evolutek/carte-vitrine-2022/V1/Output/Schematics.pdf

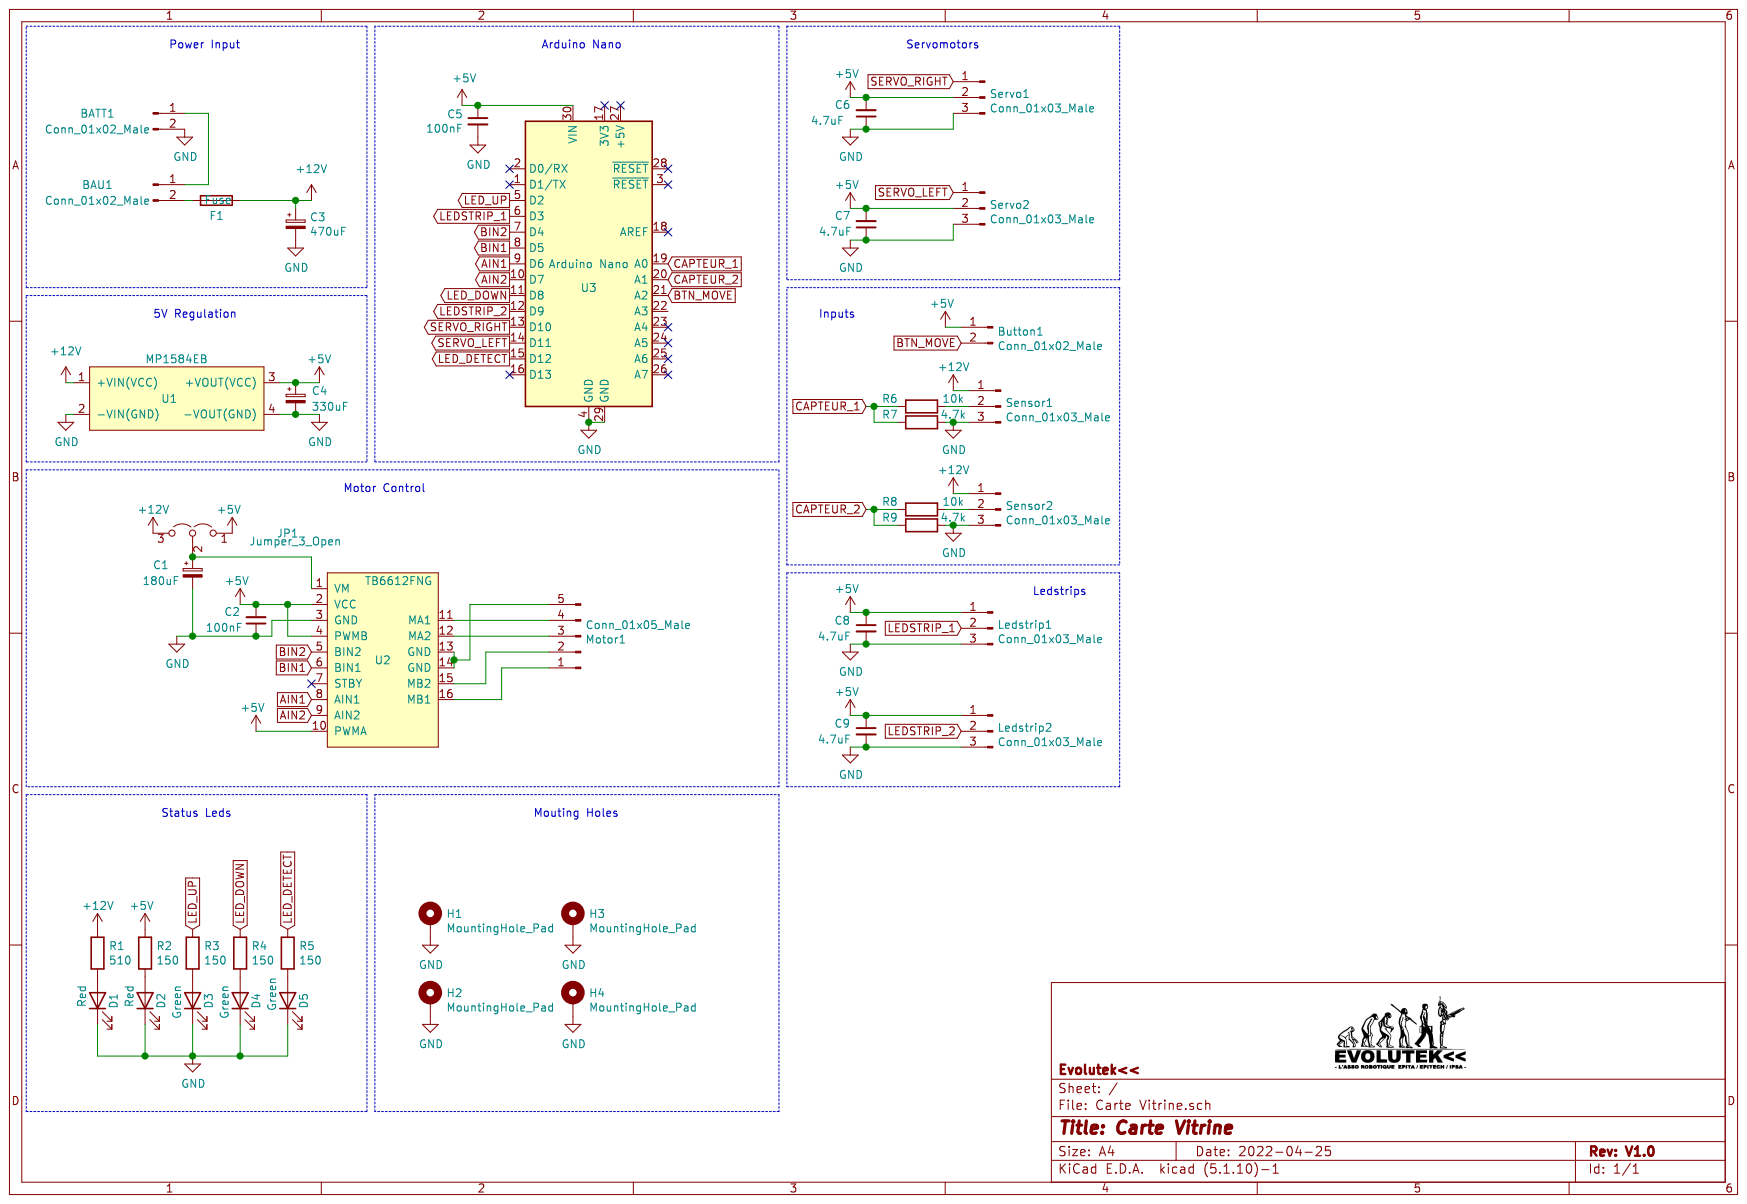
[picture p1: page 1]
