evolutek/carte-vitrine-2022/V1/Output/Front-Board.pdf

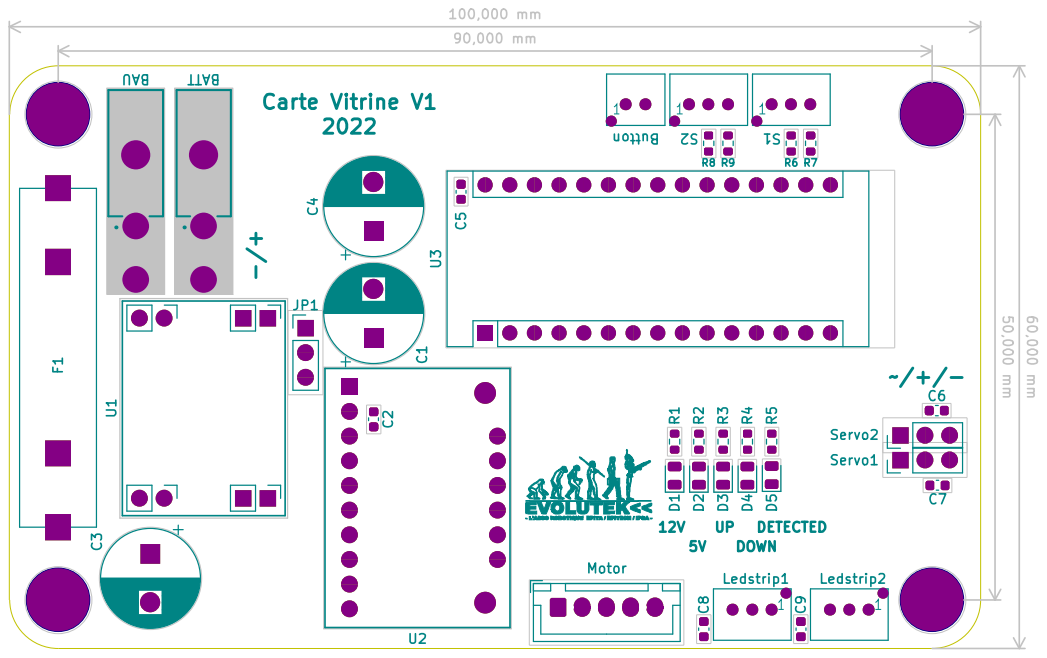
[picture p2: page 1]
