evolutek/carte-vitrine-2022/V1/Carte Vitrine.kicad_pcb

## KiCad design V1/Carte Vitrine.kicad_pcb (2022-04-25)

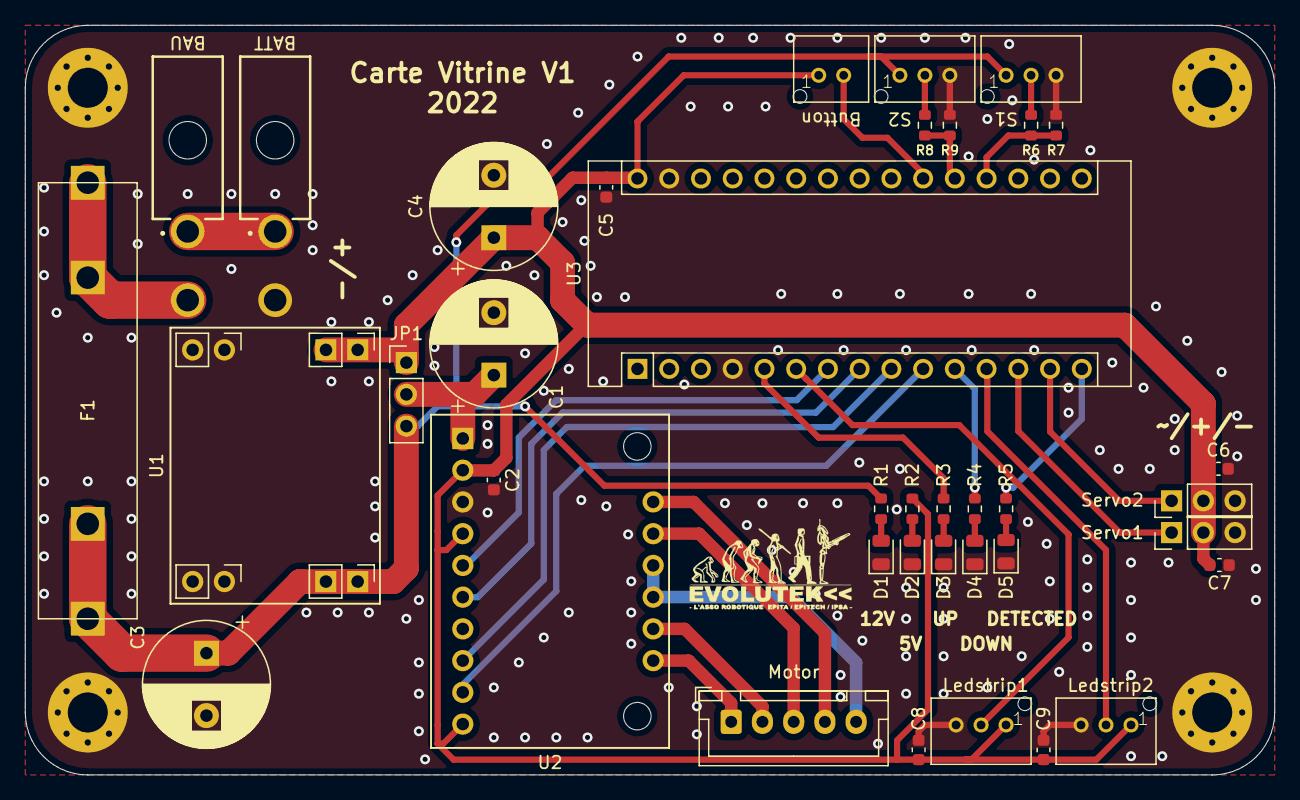
[picture p3: board Carte Vitrine.kicad_pcb from above]

Board: 2 copper layers, 100.0 x 60.0 mm, 42 parts (0 on the bottom side), 32 nets.

Parts:
BATT: Conn_01x02_Male; 649002227222
BAU: Conn_01x02_Male; 649002227222
Button: Conn_01x02_Male; B02B-PASK
C1: 180uF; CP_Radial_D10.0mm_P5.00mm
C2, C5: 100nF; C_0603_1608Metric
C3: 470uF; CP_Radial_D10.0mm_P5.00mm
C4: 330uF; CP_Radial_D10.0mm_P5.00mm
C6, C7, C8, C9: 4.7uF; C_0603_1608Metric
D1, D2: Red; LED_0805_2012Metric
D3, D4, D5: Green; LED_0805_2012Metric
F1: Fuse; 8040-PORTE-FUSIBLE
H1, H2, H3, H4: MountingHole_Pad; MountingHole_3.2mm_M3_Pad_Via
JP1: Jumper_3_Open; PinHeader_1x03_P2.54mm_Vertical
Ledstrip1, Ledstrip2: Conn_01x03_Male; B03B-PASK
Motor: Conn_01x05_Male; JST_XH_B5B-XH-A_1x05_P2.50mm_Vertical
R1: 510; R_0603_1608Metric
R2, R3, R4, R5: 150; R_0603_1608Metric
R6, R8: 10k; R_0603_1608Metric
R7, R9: 4.7k; R_0603_1608Metric
S1, S2: Conn_01x03_Male; B03B-PASK
Servo1, Servo2: Conn_01x03_Male; PinHeader_1x03_P2.54mm_Vertical
U1: MP1584EB; MP1584EN
U2: TB6612FNG
U3: Arduino Nano; ArduinoNano

Connections:
+5V: Button.1, C2.2, C4.1, C5.1, C6.2, C7.2, C8.1, C9.1, JP1.1, Ledstrip1.1, Ledstrip2.1, R2.1, Servo1.2, Servo2.2, U1.3, U2.2, U2.4, U2.10, U3.30
+12V: C3.1, F1.2, JP1.3, R1.1, S1.1, S2.1, U1.1
AIN1: U2.8, U3.9
AIN2: U2.9, U3.10
BIN1: U2.6, U3.8
BIN2: U2.5, U3.7
BTN_MOVE: Button.2, U3.21
CAPTEUR_1: R6.2, R7.2, U3.19
CAPTEUR_2: R8.2, R9.2, U3.20
GND: BATT.2, C1.2, C2.1, C3.2, C4.2, C5.2, C6.1, C7.1, C8.2, C9.2, D1.1, D2.1, D3.1, D4.1, D5.1, H1.1, H2.1, H3.1, H4.1, Ledstrip1.3, Ledstrip2.3, R7.1, R9.1, S1.3, S2.3, Servo1.3, Servo2.3, U1.2, U1.4, U2.3, U3.4, U3.29
LEDSTRIP_1: Ledstrip1.2, U3.6
LEDSTRIP_2: Ledstrip2.2, U3.12
LED_DETECT: R5.1, U3.15
LED_DOWN: R4.1, U3.11
LED_UP: R3.1, U3.5
unnamed: BATT.1, BAU.1
unnamed: BAU.2, F1.1
unnamed: C1.1, JP1.2, U2.1
unnamed: D1.2, R1.2
unnamed: D2.2, R2.2
unnamed: D3.2, R3.2
unnamed: D4.2, R4.2
unnamed: D5.2, R5.2
unnamed: Motor.1, U2.16
unnamed: Motor.2, U2.15
unnamed: Motor.3, U2.12
unnamed: Motor.4, U2.11
unnamed: Motor.5, U2.13, U2.14
unnamed: R6.1, S1.2
unnamed: R8.1, S2.2
SERVO_LEFT: Servo2.1, U3.14
SERVO_RIGHT: Servo1.1, U3.13
