evolutek/carte-vitrine-2022/Code/Vitrine/LedStripDriver.h

#pragma once

#include "Driver.h"

#include <Adafruit_NeoPixel.h>


class LedStripDriver : public Driver {
    private:

    Adafruit_NeoPixel ledStrip;
    EventsDriver *events;


    public:

    LedStripDriver(EventsDriver &events, int pin, int len) {
        this->ledStrip = Adafruit_NeoPixel(len, pin, NEO_RGB + NEO_KHZ800);
        this->events = &events;
    }

    void init() {
      ledStrip.begin();
      ledStrip.setBrightness(255);
    }

    void setLedColor(int pos, uint32_t color) {
        ledStrip.setPixelColor(pos, color);
    }

    void setAllColor(uint32_t color) {
        ledStrip.fill(color, 0, ledStrip.numPixels());
    }

    void update() {
        ledStrip.show();
    }

    void enable() {
        ledStrip.setBrightness(255);
        update();
    }

    void disable() {
        ledStrip.setBrightness(0);
        update();
    }
};
