evolutek/carte-vitrine-2022/Code/Vitrine/Utils.h

#include "EventsDriver.h"


// Drivers

#include "LedStripDriver.h"
#include "StepMotorDriver.h"
#include "ButtonDriver.h"
#include "LedDriver.h"
#include "ServoDriver.h"


// Tests

#include "LedStripTest.h"
#include "LedTest.h"
#include "ServoTest.h"
#include "StepMotorTest.h"
#include "ButtonTest.h"
