evolutek/carte-vitrine-2022/(commit log)

2022-04-18 version moche
    [Vitrinev5.12.kicad_pcb, Vitrinev5.12.sch]
2022-04-19 Fix schematics and add Board
    [Carte Vitrine.kicad_pcb, Carte Vitrine.sch, Vitrinev5.12.kicad_pcb, Vitrinev5.12.sch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]
2022-04-19 Fix Front-Board.pdf and add zip
    [Carte Vitrine.kicad_pcb]
2022-04-25 Fix V1 of the board
    [Carte Vitrine.kicad_pcb, Carte Vitrine.sch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]
2022-05-20 Add drivers
2022-05-20 Functional drivers
2022-05-20 Make a better ServoDriver.h
2022-05-21 Add a README and set a default speed in ServoDriver
2022-05-22 Add missing driver init call in mainSetup
    [Main.h]
2022-05-22 Rename Code/StepperTest/StepperTest.ino to Code/StepperTest (old)/StepperTest.ino
2022-05-22 FIN CODE VITRINE
    Finalisation du code de la vitrine (TESTÉ)
2022-05-25 Rename and change stepper managment in CodeFinal.ino
